alcor6502/USB-Relay-Altium/README.md

# Altium Project for a USB Controlled Relay

## Follow the project on [Hackaday](https://hackaday.io)

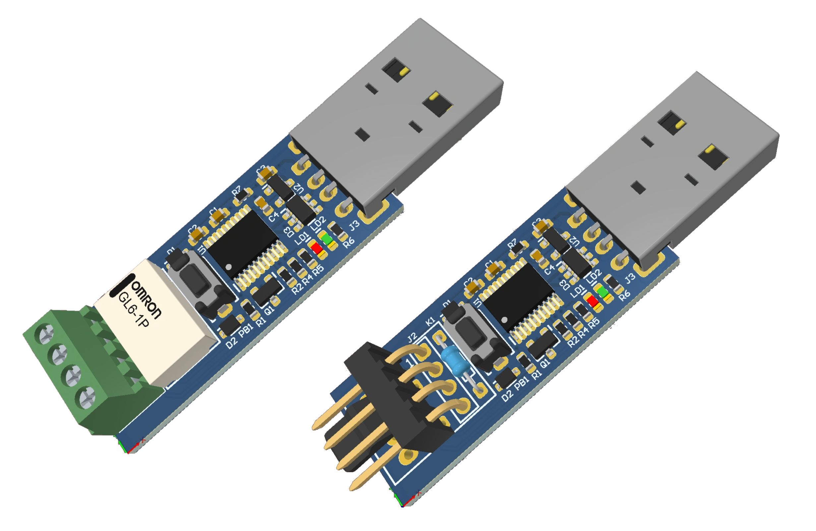
[picture p1: Documentation/Pictures/Board.png]
image info
