alcor6502/USB-Relay-Altium/Documentation/USB-SW-A/Design Rules Check.html

Altium

# Design Rule Verification Report

Date: | | 24/10/2024
Time: | | 17:12:43
Elapsed Time: | | 00:00:01
Filename: | | C:\Users\alfredo\AppData\Local\TempReleases\Snapshot\1\USB-SW.PcbDoc

Warnings: | | 0
Rule Violations: | | 0

## Summary

Warnings | Count
Total | 0

Rule Violations | Count
Clearance Constraint (Gap=0.2mm) (All),(All) | 0
Short-Circuit Constraint (Allowed=No) (All),(All) | 0
Un-Routed Net Constraint ( (All) ) | 0
Modified Polygon (Allow modified: No), (Allow shelved: No) | 0
Width Constraint (Min=0.1mm) (Max=5mm) (Preferred=0.2mm) (All) | 0
Routing Layers(All) | 0
Routing Via (MinHoleWidth=0.15mm) (MaxHoleWidth=1mm) (PreferredHoleWidth=0.3mm) (MinWidth=0.25mm) (MaxWidth=2mm) (PreferedWidth=0.5mm) (All) | 0
Differential Pairs Uncoupled Length using the Gap Constraints (Min=0.1mm) (Max=0.14mm) (Prefered=0.14mm) and Width Constraints (Min=0.3mm) (Max=0.4mm) (Prefered=0.4mm) (InDifferentialPair ('USB_D') Or InDifferentialPair ('USB_CON_D')) | 0
SMD To Corner (Distance=0.1mm) (All) | 0
SMD Entry (Side = Allowed) (Corner = Allowed) (Any Angle = Allowed) (Ignore First Corner = Allowed) | 0
Power Plane Connect Rule(Direct Connect )(Expansion=0.5mm) (Conductor Width=0.2mm) (Air Gap=0.2mm) (Entries=4) (All) | 0
Minimum Annular Ring (Minimum=0.1mm) (IsVia) | 0
Minimum Annular Ring (Minimum=0mm) (IsPad AND(PadIsPlated = 'False') AND IsPadHoleValid AND (PadXSize_AllLayers > 0) AND (PadYSize_AllLayers > 0)) | 0
Minimum Annular Ring (Minimum=0.2mm) (IsPad) | 0
Acute Angle Constraint [Tracks Only] (Minimum=60.000) (All) | 0
Hole Size Constraint (Min=0.5mm) (Max=10mm) (isPad AND PadIsPlated AND HasSlotHole AND IsPadHoleValid) | 0
Hole Size Constraint (Min=0.15mm) (Max=1mm) (IsVia) | 0
Hole Size Constraint (Min=0.15mm) (Max=100mm) (IsPad) | 0
Hole Size Constraint (Min=0.5mm) (Max=100mm) (isPad AND NOT PadIsPlated AND NOT HasSlotHole AND IsPadHoleValid) | 0
Hole Size Constraint (Min=1mm) (Max=10mm) (isPad AND NOT PadIsPlated AND HasSlotHole AND IsPadHoleValid) | 0
Pads and Vias to follow the Drill pairs settings | 0
Hole To Hole Clearance (Gap=0.2mm) (IsVia),(IsVia) | 0
Hole To Hole Clearance (Gap=0.45mm) (IsPad),(IsPad) | 0
Minimum Solder Mask Sliver (Gap=0.2mm) (All),(All) | 0
Silk To Solder Mask (Clearance=0.1mm) (All),(All) | 0
Silk to Silk (Clearance=0.1mm) (All),(All) | 0
Silk to Silk (Clearance=0.15mm) (IsPad),(All) | 0
Net Antennae (Tolerance=0mm) (All) | 0
Board Clearance Constraint (Gap=0mm) ((OnLayer('Top Layer') OR OnLayer('Bottom Layer'))) | 0
Parallel Segment Constraint (Gap=0.2mm ) (Limit=200mm) (All),(All) | 0
Matched Lengths(Delay Tolerance=50ps) (InDifferentialPair ('USB_D') Or InDifferentialPair ('USB_CON_D')) | 0
Daisy Chain Stub Length(Maximum =4mm) (All) | 0
Vias Under SMD Constraint (Allowed=Not Allowed) (All) | 0
Component Clearance Constraint ( Horizontal Gap = 0mm, Vertical Gap = 0mm ) (Footprint Like('FID-1*')),(All) | 0
Component Clearance Constraint ( Horizontal Gap = 0.2mm, Vertical Gap = 0.2mm ) (All),(All) | 0
Component Clearance Constraint ( Horizontal Gap = 0mm, Vertical Gap = 0mm ) ((InComponent('J2') OR InComponent('J3') OR InComponent('K1'))),((InComponent('J2') OR InComponent('J3') OR InComponent('K1'))) | 0
Height Constraint (Min=0mm) (Max=50mm) (Prefered=12mm) (All) | 0
Total | 0
