alcor6502/USB-Relay-Altium/Documentation/Data Sheets/MCU/TIM2 Block diagram.png

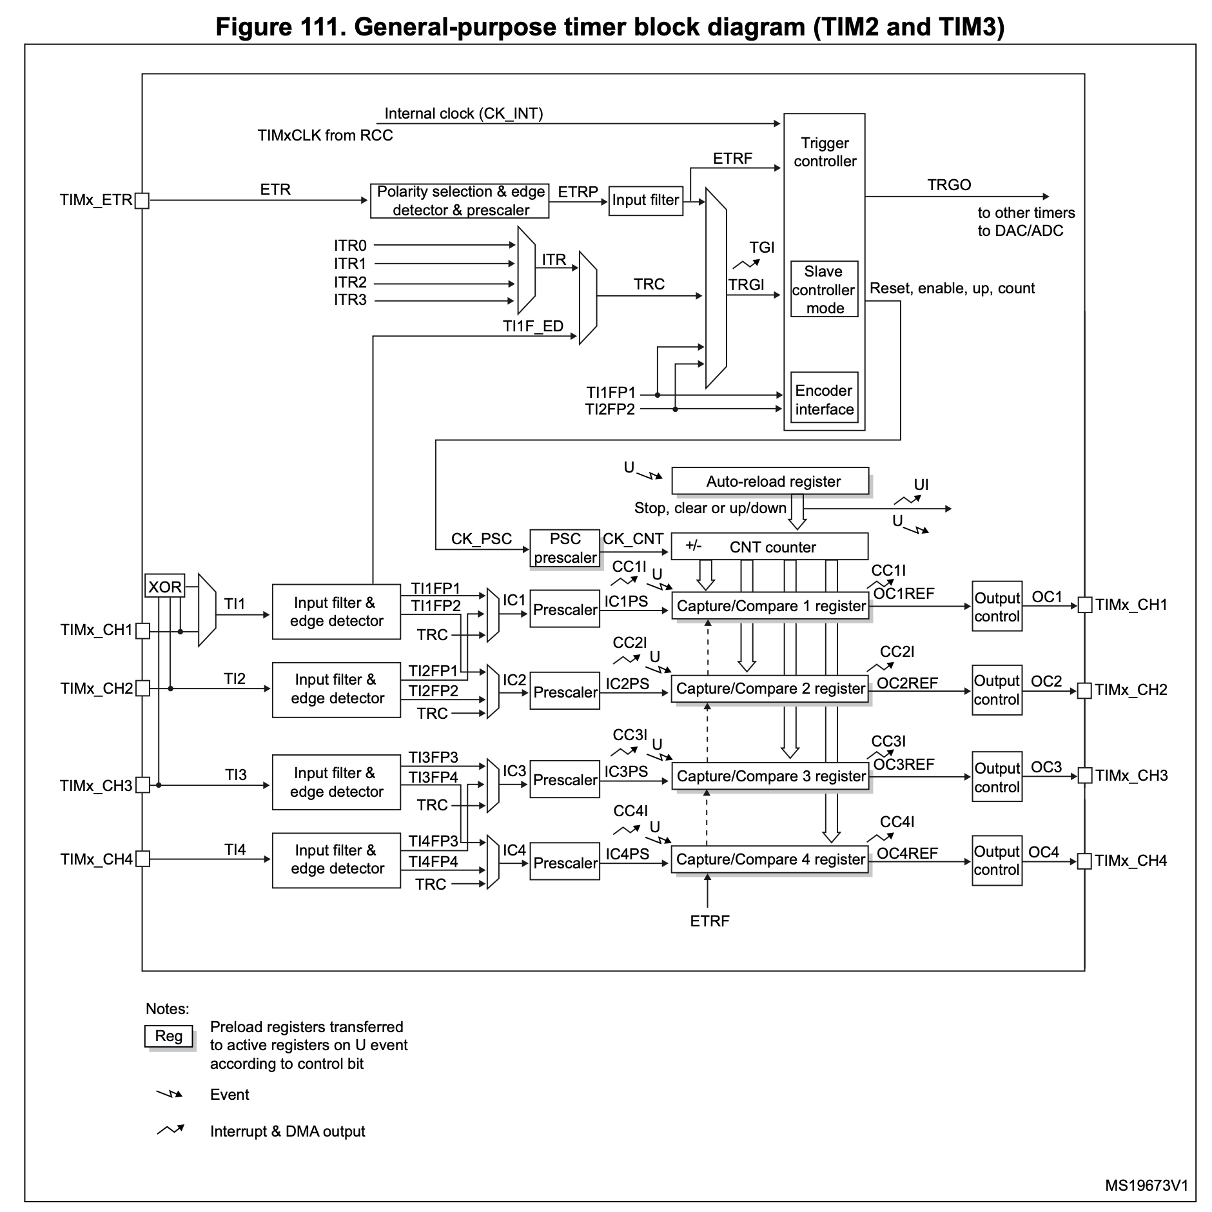
Documentation/Data Sheets/MCU/TIM2 Block diagram.png
