alcor6502/USB-Relay-Altium/Documentation/Pictures/Board Fan.png

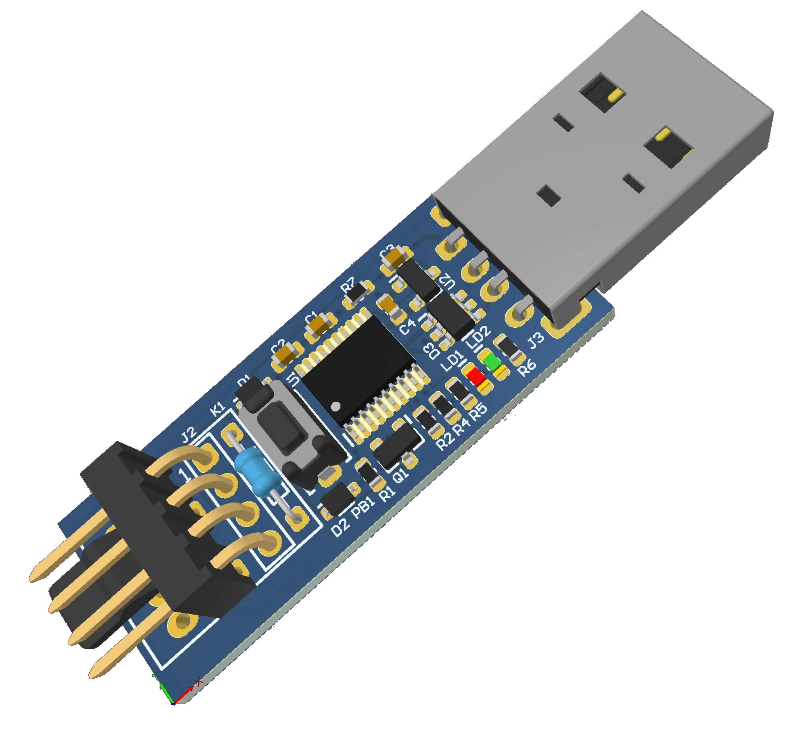
Documentation/Pictures/Board Fan.png
