alcor6502/USB-Relay-Altium/Documentation/USB-SW-B/BOM Complete.xls

Board: USB-SW-B |  |  |  |  |  |  |  | USB-SW-B
Project: USB Controlled Relay |  |  |  |  |  |  |  | USB Controlled Relay
Revision: B |  |  |  |  |  |  |  | B
Variant: None |  |  |  |  |  |  |  | None
 |  |  |  |  |  |  |  | 16/02/2025
Line # | Designator | Manufacturer | Manufacturer Part Number | Description | Case | Mount | Quantity | Supplier 1 | Supplier Part Number 1 | Supplier Order Qty 1 | Supplier Stock 1 | Supplier Unit Price 1 | Supplier Subtotal 1
1 | C1 | TDK | CGA3E2X7R1H104K080AA | Cap 0603 Case Ceramic 100nF 50V X7R | 0603 | Surface Mount | 1 | Mouser | 810-CGA3E2X7R1H104K | 10 | 1401871 | 0.04 | 0.38
2 | C2, C3, C4 | TDK | C1608X7R1C105K080AC | Cap 0603 Case Ceramic 1uF 16V X7R | 0603 | Surface Mount | 3 | Mouser | 810-C1608X7R1C105K | 30 | 255141 | 0.05 | 1.59
3 | D1, D2 | ON Semiconductor | MBR0530T1G | Diode Schottky 30V 0.5A 2-Pin SOD-123 | SOD-123 | Surface Mount | 2 | Mouser | 863-MBR0530T1G | 20 | 1564906 | 0.14 | 2.78
4 | D3 | STMicroelectronics | USBLC6-4SC6 | ESD Protection Diodes / TVS Diodes 2 Line 2.5pF USB 2.0 ESD Protect SOT23-6 | SOT-23-6 | Surface Mount | 1 | Mouser | 511-USBLC6-4SC6 | 10 | 47580 | 0.23 | 2.33
5 | J1 | Wurth Electronics | 691210910004 | Conn Term Block Header Screw 2.54 mm 4 Pos 6A 150V |  | Through Hole | 1 | Mouser | 710-691210910004 | 10 | 2027 | 1.77 | 17.70
6 | J2 | Moddy | CO975 | Conn Post Header - PWM Fan - 90 Deg - 4 Pos - Series KK254 |  | Through Hole | 1 | Moddy | CO975 | 10 | 1000 | 0.44 | 4.40
7 | J3 | Adam Tech | USB-AP-S-RA | Conn USB Type A Plug Right-Anglel TH |  | Through Hole | 1 | Mouser | 737-USB-AP-S-RA | 10 | 15588 | 0.34 | 3.35
8 | K1 | Omron | G6L-1P-DC5 | Relay Low Signal Sealed SPST-NO 1A 5VDC Through Hole Tube |  | Through Hole | 1 | Mouser | 653-G6L-1P-DC5 | 10 | 4124 | 2.37 | 23.70
9 | LD1 | Vishay Semiconductors | LTST-C191KRKT | LED 0603 Top Red 631nm 2-Pin | 0603 | Surface Mount | 1 | Mouser | 859-LTST-C191KRKT | 10 | 153119 | 0.12 | 1.17
10 | LD2 | Vishay Semiconductors | LTST-C191KGKT | LED 0603 Top Green 571nm 2-Pin | 0603 | Surface Mount | 1 | Mouser | 859-LTST-C191KGKT | 10 | 109093 | 0.12 | 1.25
11 | PB1 | Alps Alpine | SKQMAQE010 | Tactile Switch Rectangular 6.00x3.55mm. Height 4.3mm. J-Lead 50mA 12VDC 260gf SMD |  | Surface Mount | 1 | Mouser | 688-SKQMAQ | 10 | 2709 | 0.66 | 6.57
12 | Q1 | Diodes | BSS138-7-F | Mosfet N 50V Vds 20V Vgs 1.4R SOT-23 | SOT-23 | Surface Mount | 1 | Mouser | 621-BSS138-7-F | 10 | 145289 | 0.09 | 0.85
13 | R1, R4, R7 | Yageo | RC0603FR-0710KL | Resistor 0603 Case 10KR 1% 1/10W | 0603 | Surface Mount | 3 | Mouser | 603-RC0603FR-0710KL | 30 | 4994490 | 0.01 | 0.27
14 | R2, R5, R6 | Yageo | RC0603FR-07470RL | Resistor 0603 Case 470R 1% 1/10W | 0603 | Surface Mount | 3 | Mouser | 603-RC0603FR-07470RL | 30 | 728372 | 0.01 | 0.24
15 | R3 | SEI Stackpole | RNF18FTD10K0 | Resistor Axial 10KR 1% 1/8W | Through Hole | Through Hole | 1 | Mouser | 708-RNF18FTD10K0 | 10 | 102462 | 0.04 | 0.35
16 | U1 | STMicroelectronics | STM32F070F6P6 | STM32 Arm Cortex-M0 MCU 32 Kbytes of Flash 48 MHz CPU, USB | TSSOP-20 | Surface Mount | 1 | Mouser | 511-STM32F070F6P6TR | 10 | 1828 | 1.05 | 10.50
17 | U2 | Diodes | AP7313-33SRG-7 | LDO 3.3V 150mA Out 6Vin 130mV Dropout, Quiescent current 65uA Startup 80µs SOT-23 | SOT-23 | Surface Mount | 1 | Mouser | 621-AP7313-33SRG-7 | 10 | 54165 | 0.16 | 1.61
 | Total Parts | 17 |  |  |  |  | 10 | pcs: | Total | $79.04
 | Surface Mount Parts | 12
 | Through Hole Parts | 5 |  |  |  |  |  |  | Price for 1pcs | $7.90
 | Free Hanging Parts | 0
