alcor6502/USB-Relay-Altium/Documentation/USB-SW-A/BOM Complete.xls

Board: USB-SW-A |  |  |  |  |  |  |  | USB-SW-A
Project: USB controlled Relay |  |  |  |  |  |  |  | USB controlled Relay
Revision: A |  |  |  |  |  |  |  | A
Variant: None |  |  |  |  |  |  |  | None
 |  |  |  |  |  |  |  | 24/10/2024
Line # | Designator | Manufacturer | Manufacturer Part Number | Description | Case | Mount | Quantity | Supplier 1 | Supplier Part Number 1 | Supplier Order Qty 1 | Supplier Stock 1 | Supplier Unit Price 1 | Supplier Subtotal 1
 | C1 | TDK | CGA3E2X7R1H104K080AA | Cap 0603 Case Ceramic 100nF 50V X7R | 0603 | Surface Mount | 1 | Mouser | 810-CGA3E2X7R1H104K | 100 | 2671699 | 0.02 | 2.20
 | C2, C3, C4 | TDK | C1608X7R1C105K080AC | Cap 0603 Case Ceramic 1uF 16V X7R | 0603 | Surface Mount | 3 | Mouser | 810-C1608X7R1C105K | 300 | 400455 | 0.03 | 8.40
 | D1 | STMicroelectronics | USBLC6-4SC6 | ESD Protection Diodes / TVS Diodes 2 Line 2.5pF USB 2.0 ESD Protect SOT23-6 | STO23-6 | Surface Mount | 1 | Mouser | 511-USBLC6-4SC6 | 100 | 60620 | 0.20 | 19.70
 | D2, D3 | ON Semiconductor | MBR0530T1G | Diode Schottky 30V 0.5A 2-Pin SOD-123 | SOD-123 | Surface Mount | 2 | Mouser | 863-MBR0530T1G | 200 | 1680794 | 0.08 | 16.20
 | J1 | Molex | 48037-0001 | Conn USB type A plug 4 pin Horizontal TH |  | Through Hole | 1 | Mouser | 538-48037-0001 | 100 | 6836 | 0.82 | 82.50
 | J2 | JST | S4B-XH-A(LF)(SN) | Conn Shrouded, Series JST XH, 4 Pos Header,(2.50mm) Through Hole, Right Angle Tin |  | Through Hole | 1 | Mouser | 306-S4B-XH-ALFSN | 100 | 61319 | 0.23 | 23.00
 | J3 | Molex | 70553-0038 | Conn Shrouded, Series Molex 70058, 4 Pos Header, (2.54mm) Through Hole, Right Angle Tin |  | Through Hole | 1 | Mouser | 538-70553-0038 | 100 | 6334 | 0.59 | 58.70
 | K1 | Omron | G6L-1P-DC5 | Relay Low Signal Sealed SPST-NO 1A 5VDC Through Hole Tube |  | Through Hole | 1 | Mouser | 653-G6L-1P-DC5 | 100 | 5264 | 1.90 | 190.00
 | LD1 | Vishay Lite-On | LTST-C191KRKT | LED 0603 Top Red 631nm 2-Pin | 0603 | Surface Mount | 1 | Mouser | 859-LTST-C191KRKT | 100 | 169916 | 0.05 | 5.30
 | LD2 | Vishay Lite-On | LTST-C191KGKT | LED 0603 Top Green 571nm 2-Pin | 0603 | Surface Mount | 1 | Mouser | 859-LTST-C191KGKT | 100 | 435065 | 0.05 | 5.20
 | PB1 | E-Switch | TL3302AF180QJ | Tactile Switch Rectangular 6.00x3.55mm. Height 4.3mm. J-Lead 50mA 12VDC 180gf SMD |  | Through Hole | 1
 | Q1 | Diodes | BSS138K-13 | Mosfet N 50V Vds 20V Vgs ESD 1.4R SOT-23 | SOT-23 | Surface Mount | 1 | Mouser | 621-BSS138K-13 | 100 | 334784 | 0.06 | 5.90
 | R1, R2, R6, R7 | Yageo | RC0603FR-0710KL | Resistor 0603 Case 10KR 1% 1/10W | 0603 | Surface Mount | 4 | Mouser | 603-RC0603FR-0710KL | 400 | 261371 | 0.01 | 2.80
 | R3, R4, R5 | Yageo | RC0603FR-07470RL | Resistor 0603 Case 470R 1% 1/10W | 0603 | Surface Mount | 3 | Mouser | 603-RC0603FR-07470RL | 300 | 1208113 | 0.01 | 1.80
 | U1 | STMicroelectronics | STM32F042F4P6 | STM32 Arm Cortex-M0 USB line MCU 16 Kbytes of Flash 48 MHz CPU USB CAN CEC | TSSOP-20 | Surface Mount | 1 | Mouser | 511-STM32F042F4P6 | 100 | 13406 | 1.66 | 166.00
 | U2 | Diodes | AP7313-33SRG-7 | LDO 3.3V 150mA Out 6Vin 130mV Dropout, Quiescent current 65uA Startup 80µs SOT-23 | SOT-223 | Surface Mount | 1 | Mouser | 621-AP7313-33SRG-7 | 100 | 55450 | 0.13 | 13.20
 | Total Parts | 16 |  |  |  |  | 100 | pcs: | Total | $600.90
 | Surface Mount Parts | 11
 | Through Hole Parts | 5 |  |  |  |  |  |  | Price for 1pcs | $6.01
 | Free Hanging Parts | 0
