alcor6502/USB-Relay-Altium/Documentation/Data Sheets/Relays/G6L-1P.step

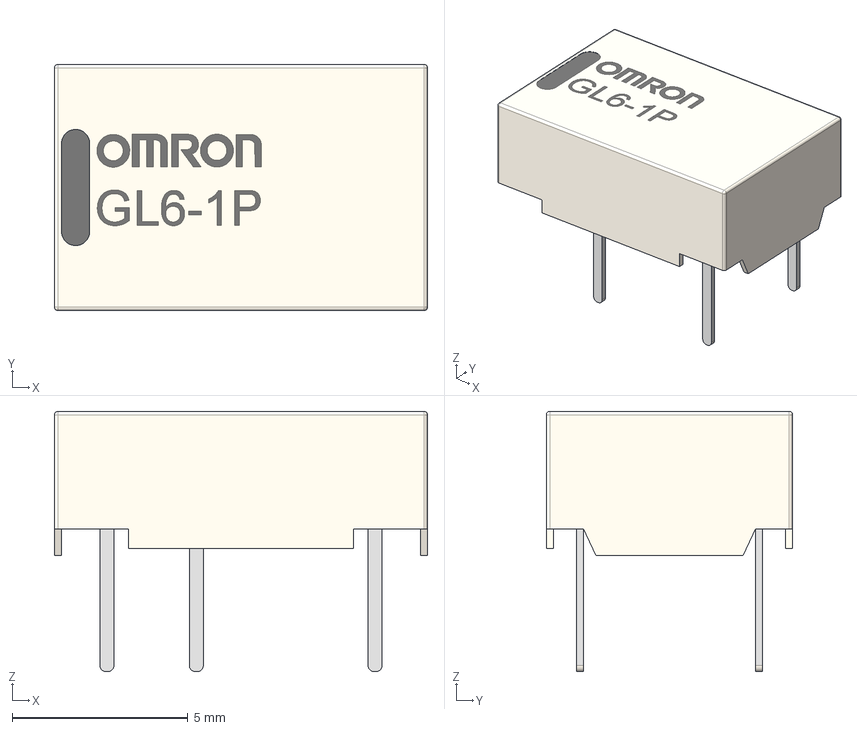
[picture p4: CAD file, 2024-09-18]
Documentation/Data Sheets/Relays/G6L-1P.step
10.6 x 7.00 x 7.40 mm
