alcor6502/USB-Relay-Altium/Documentation/USB-SW-A/Board 3D.step

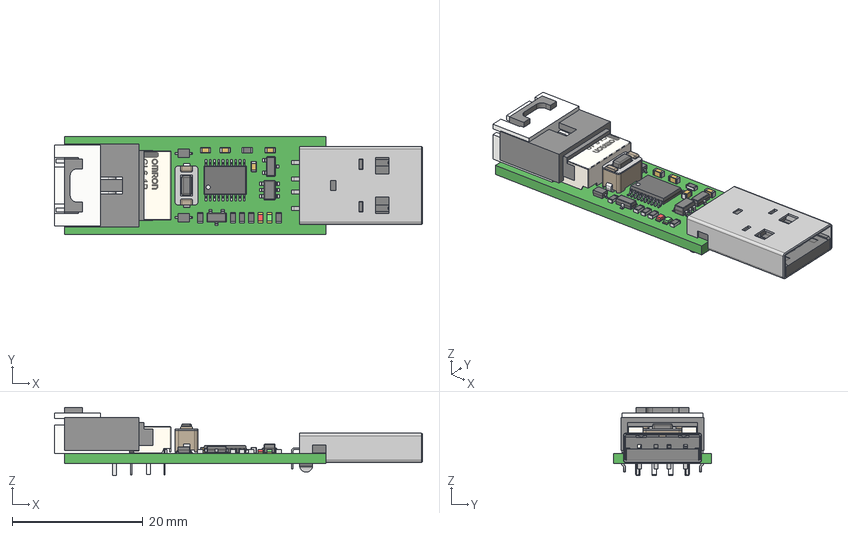
[picture p5: CAD file, 2024-10-24]
Documentation/USB-SW-A/Board 3D.step
56.3 x 15.0 x 10.4 mm
Mid_Body x 7
Mark x 7
SOD-323-J x 2
TL3302AF180QJ
Leader x 12
_X2_041A043E0440043F04430441_X0_
_X2_041C04350442043A0430_X0_
_X2_041D043E0436043A0430_X0_ x 10
Extruded x 4
G6L-1P
S4B-XH-A
