alcor6502/USB-Relay-Altium/Documentation/USB-SW-B/Board 3D.step

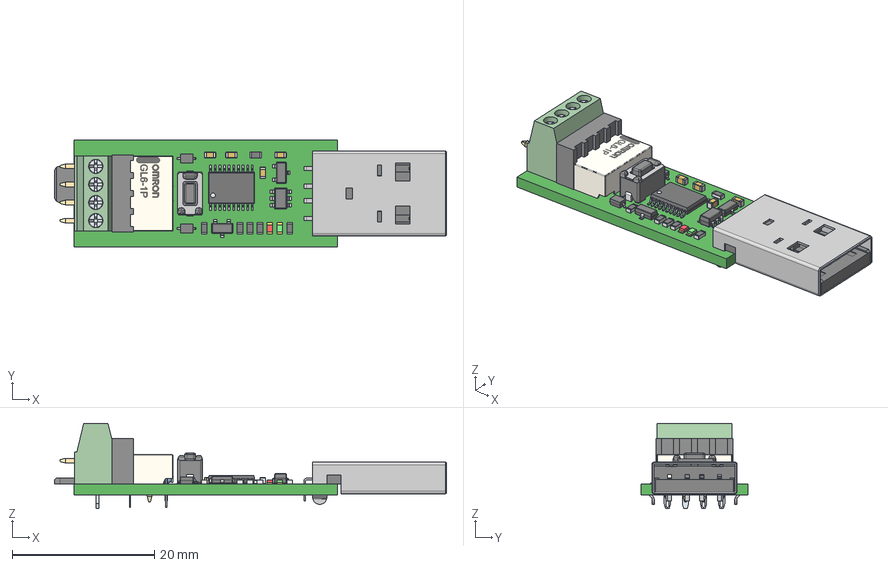
[picture p6: CAD file, 2025-02-16]
Documentation/USB-SW-B/Board 3D.step
55.0 x 15.0 x 12.0 mm
Leader x 12
Fan Header 90deg
Mid_Body x 6
Mark x 6
Resitor Through Hole 125 mW
SOD-323-J x 2
SKQMBA
_X2_041A043E0440043F04430441_X0_
_X2_041C04350442043A0430_X0_
_X2_041D043E0436043A0430_X0_ x 10
Extruded x 4
G6L-1P
6912109100xx_CAGE x 4
6912109100xx_PIN x 4
6912109100xx_VIS x 4
