alcor6502/USB-Relay-Altium/Documentation/Data Sheets/Relays/G5V-1.step

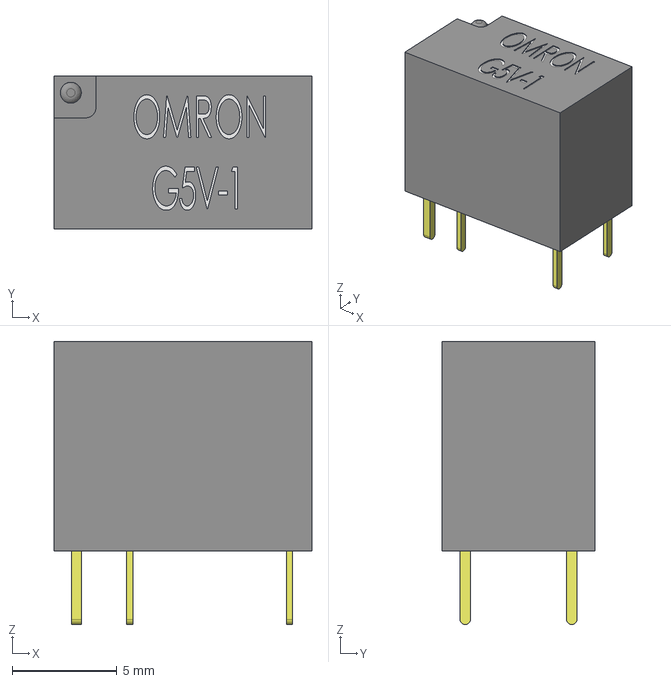
[picture p7: CAD file, 2024-09-18]
Documentation/Data Sheets/Relays/G5V-1.step
12.3 x 7.30 x 13.5 mm
