alcor6502/USB-Relay-Altium/Documentation/USB-SW-A/Schematics.PDF

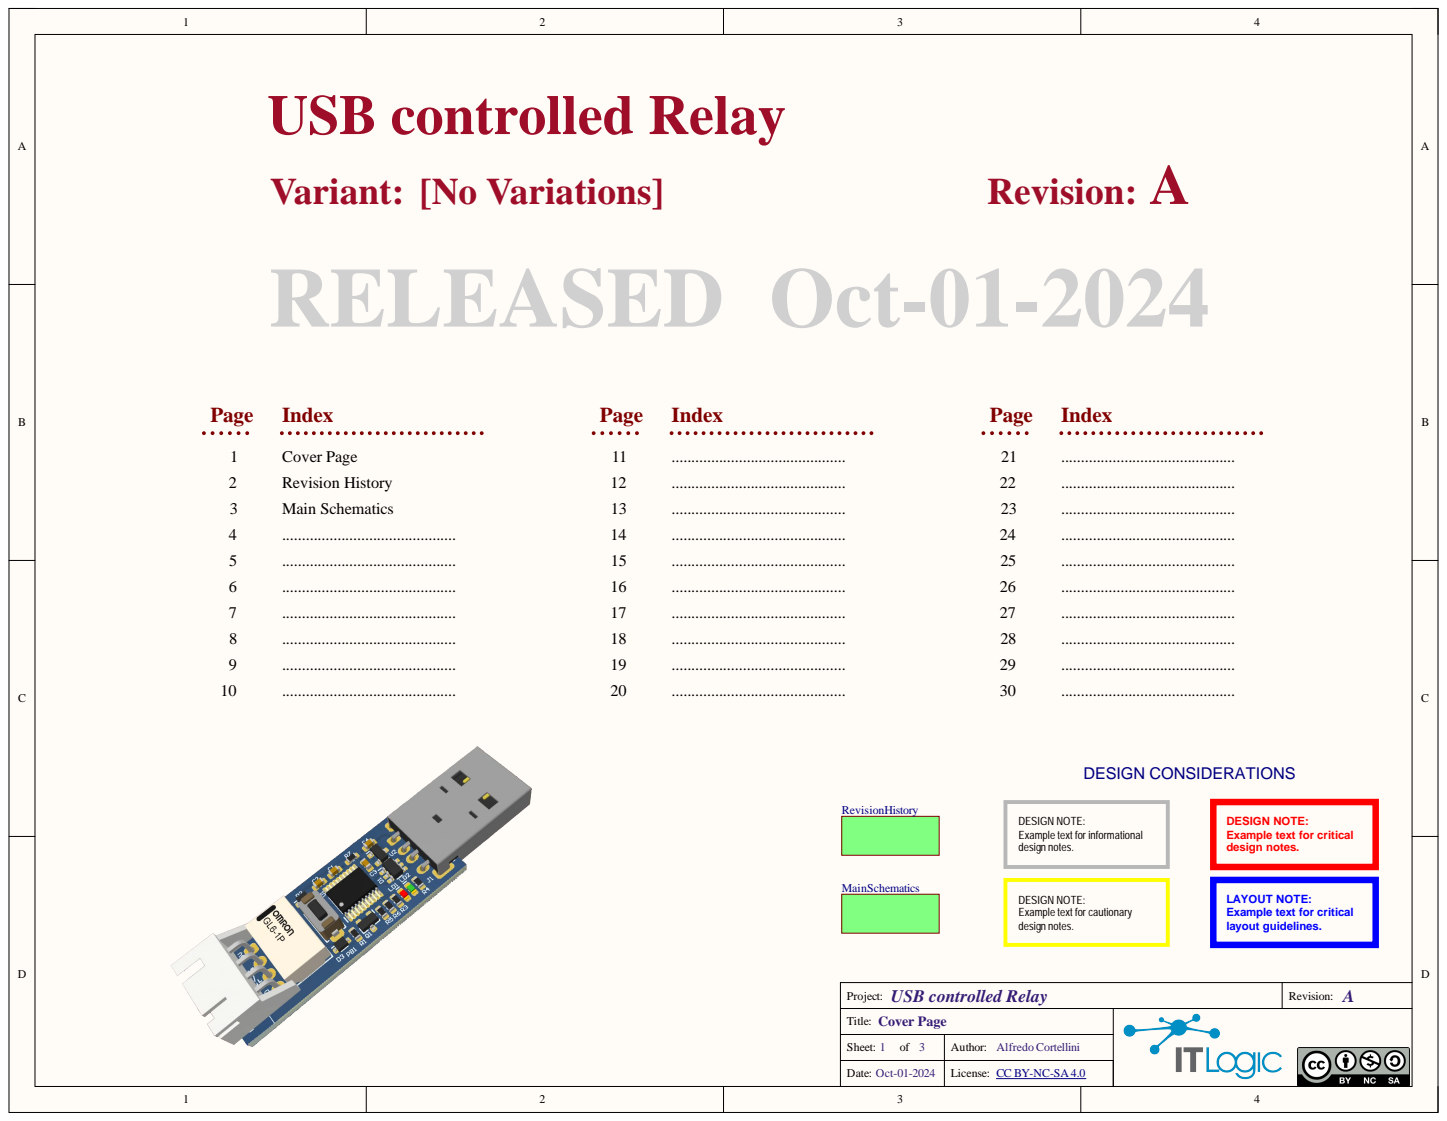
[picture p11: page 1]

DESIGN NOTE:
Example text for informational
design notes.

Example text for critical

Example text for cautionary

LAYOUT NOTE:
layout guidelines.

Project: USB controlled Relay

License: CC BY-NC-SA4.0

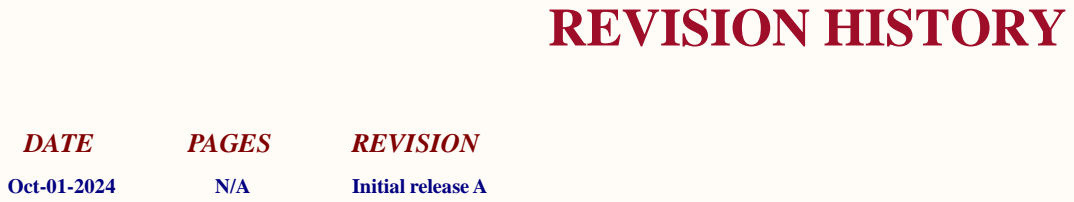
[picture p12: page 2]

Project: USB controlled Relay

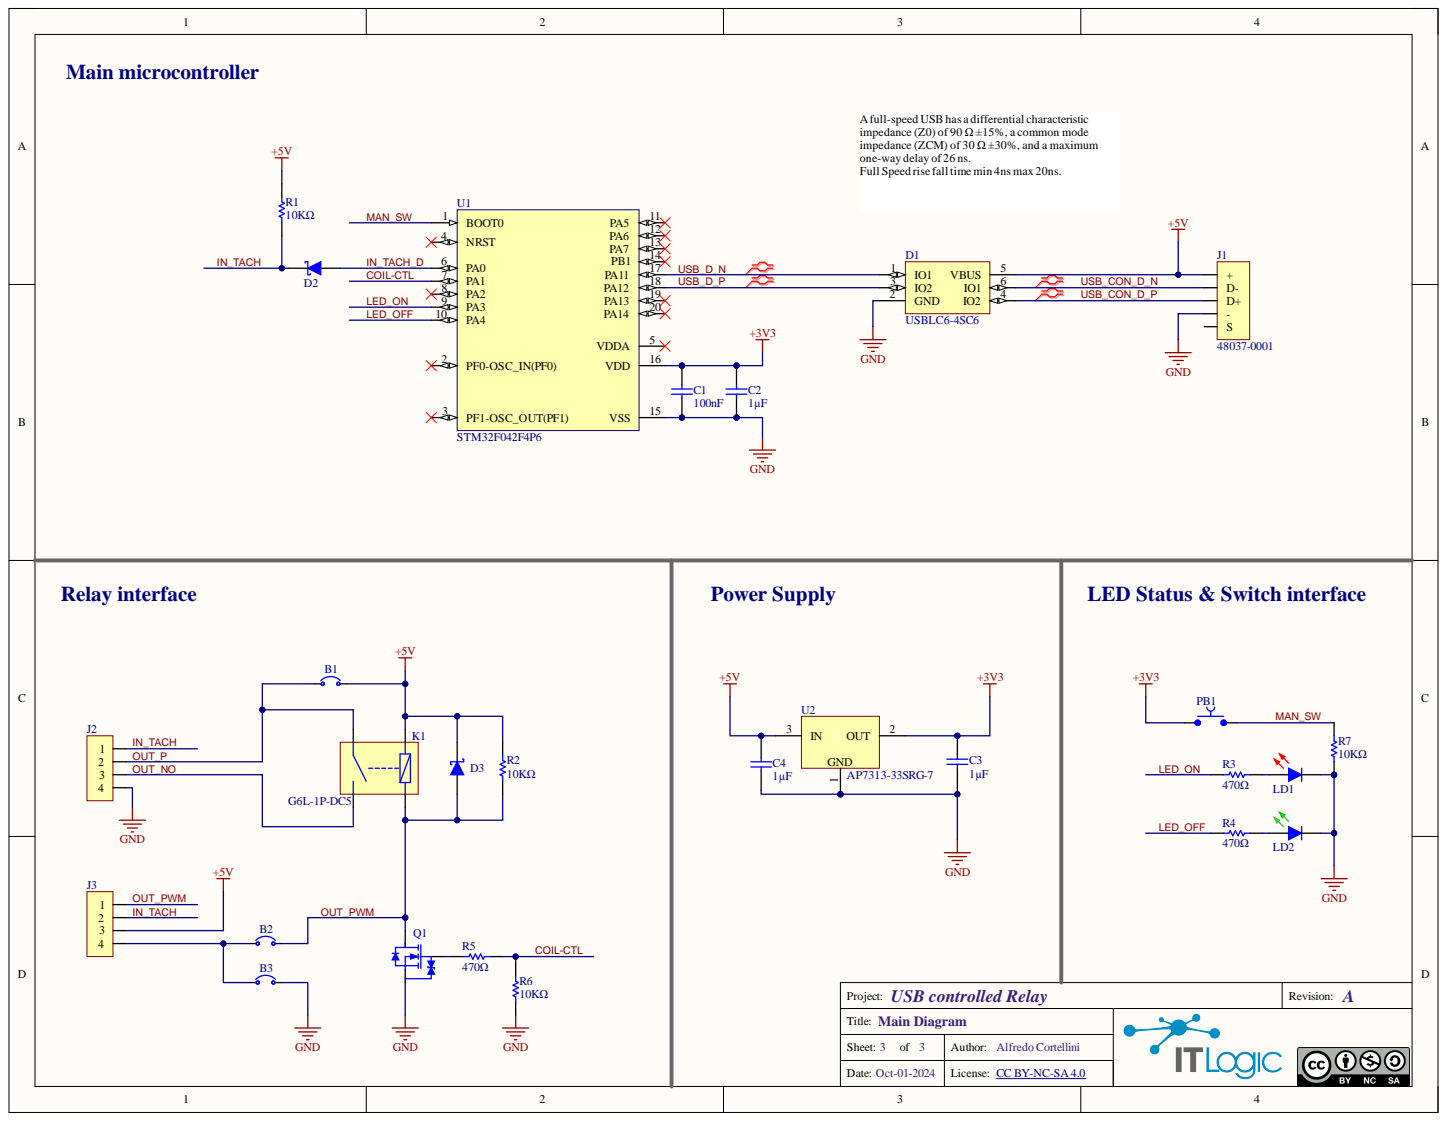
[picture p13: page 3]

Afull-speed USB has a differential characteristic
impedance (Z0) of 90 Ω ±15%, a common mode
impedance (ZCM) of 30 Ω ±30%, and a maximum
one-way delay of 26 ns.
Full Speed rise fall time min 4ns max 20ns.

Project: USB controlled Relay
