alcor6502/USB-Relay-Altium/Documentation/USB-SW-A/Drawings.pdf

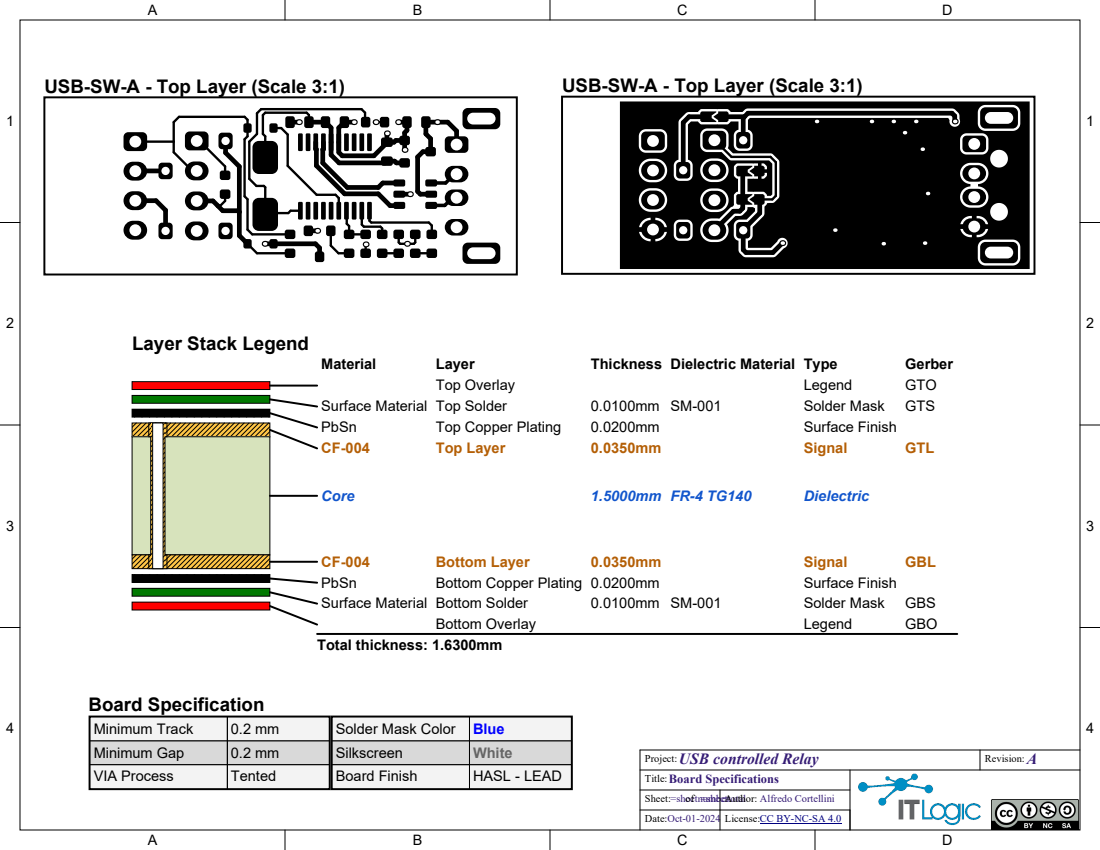
[picture p18: page 1]

Minimum Track | 0.2 mm | Solder Mask Color | Blue
Minimum Gap | 0.2 mm | Silkscreen | White
VIA Process | Tented | Board Finish | HASL - LEAD

Project:USB controlled Relay
Board Specifications
Title:

Sheet: =sheetnumber =sheettotal of | Author: Alfredo Cortellini

License:CC BY-NC-SA 4.0

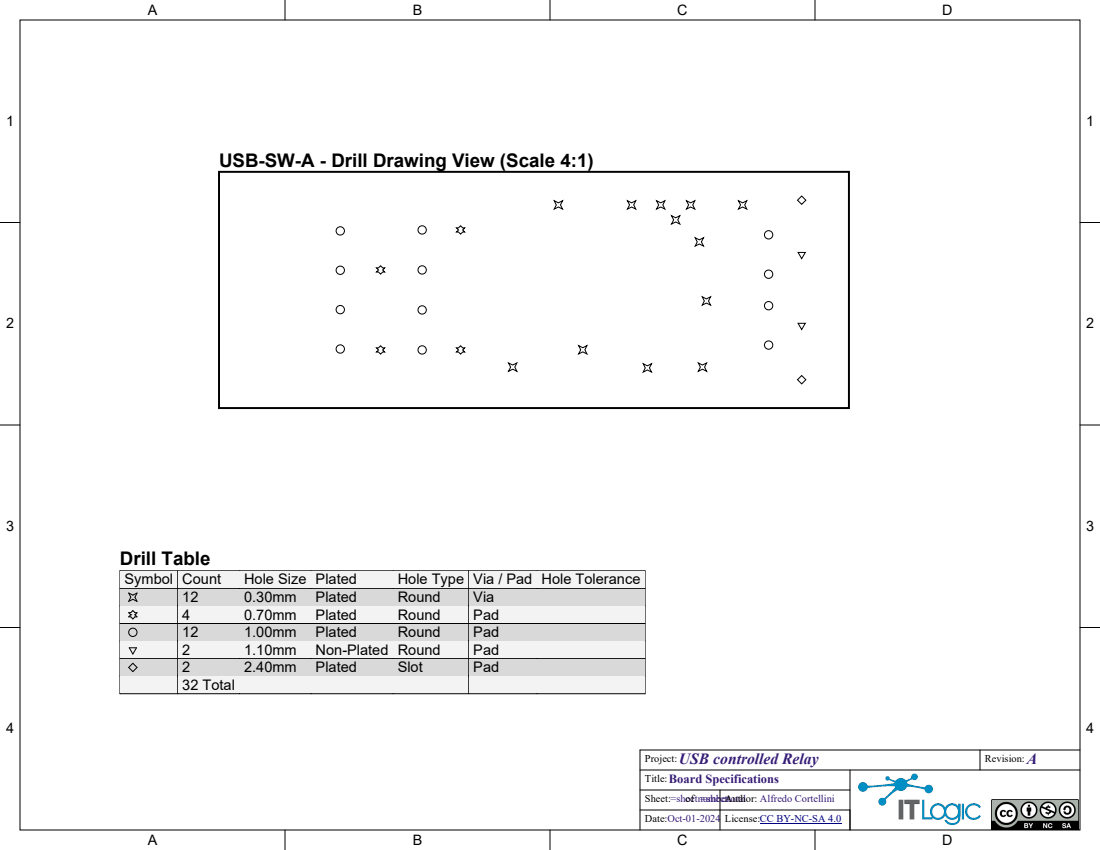
[picture p19: page 2]

USB-SW-A - Drill Drawing View (Scale 4:1)

Symbol | Count | Hole Size | Plated | Hole Type | Via / Pad | Hole Tolerance

12 | 0.30mm | Plated | Round | Via
4 | 0.70mm | Plated | Round | Pad
12 | 1.00mm | Plated | Round | Pad
2 | 1.10mm | Non-Plated | Round | Pad
2 | 2.40mm | Plated | Slot | Pad
32 Total

Project:USB controlled Relay
Board Specifications
Title:

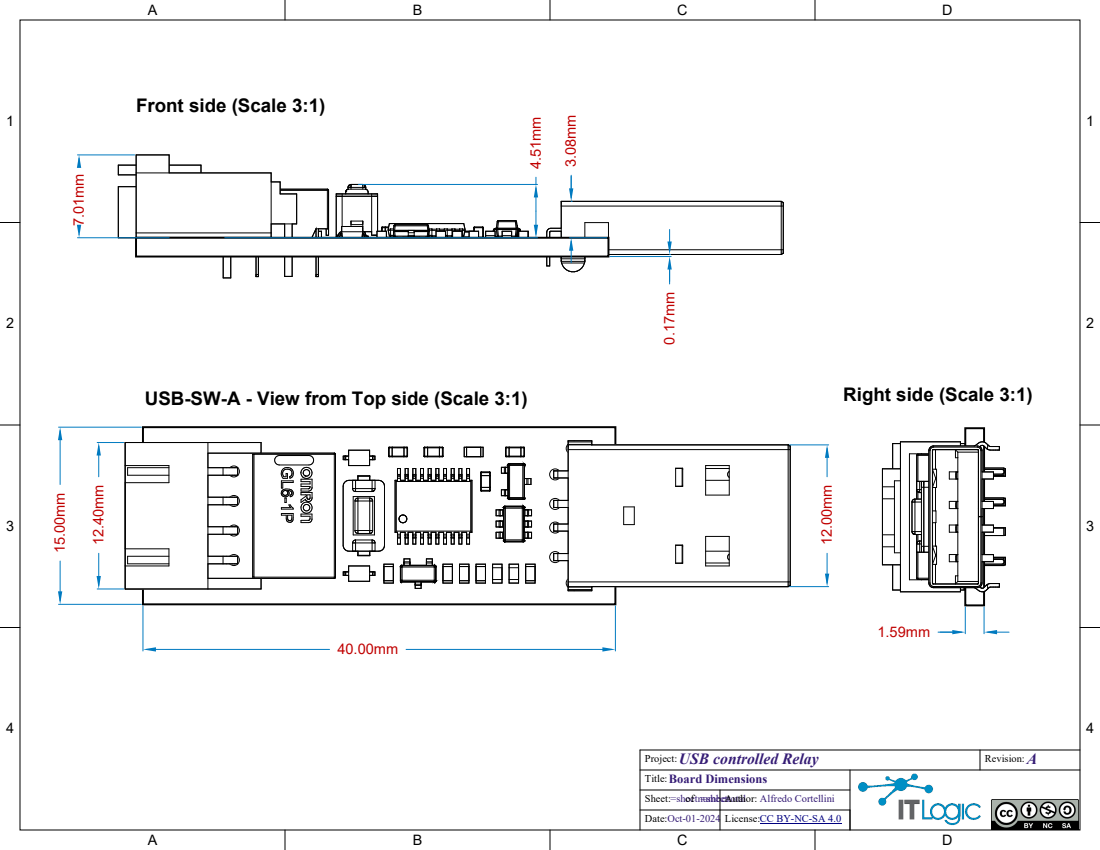
[picture p20: page 3]

USB-SW-A - View from Top side (Scale 3:1)

Project:USB controlled Relay
Board Dimensions
Title:

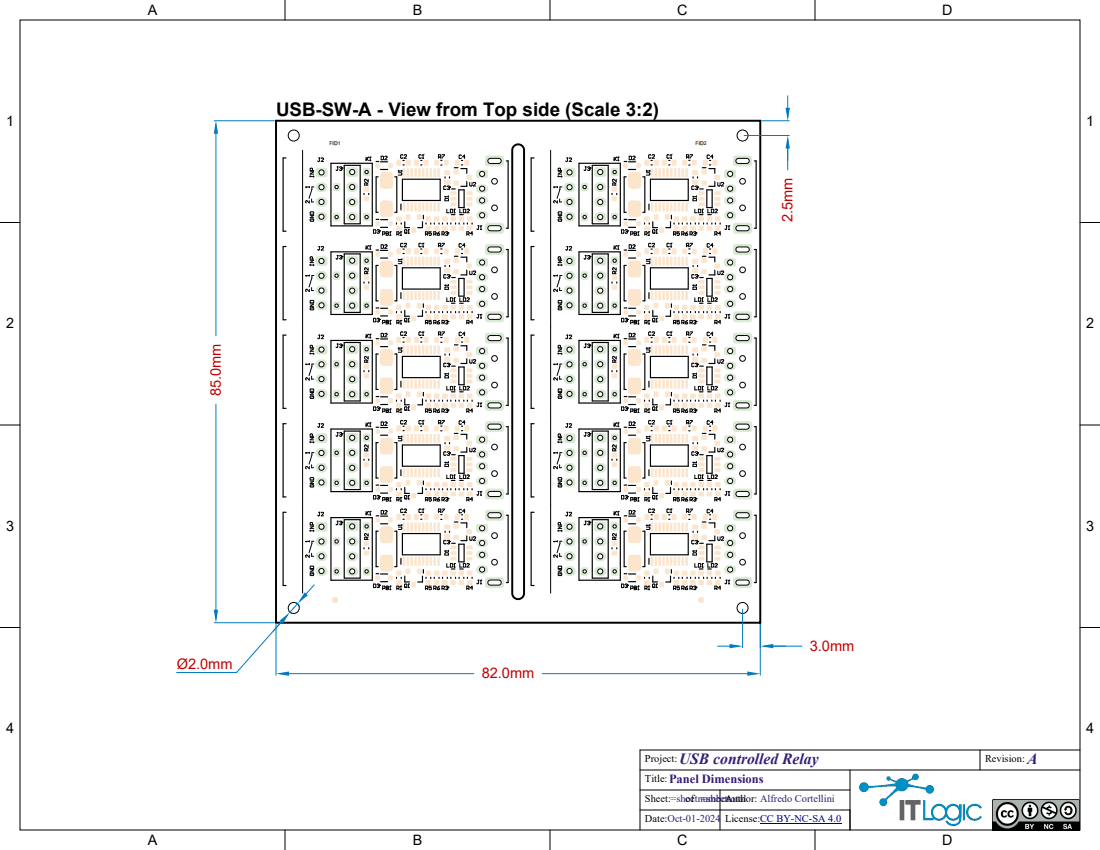
[picture p21: page 4]

USB-SW-A - View from Top side (Scale 3:2)

Project:USB controlled Relay
Panel Dimensions
Title:

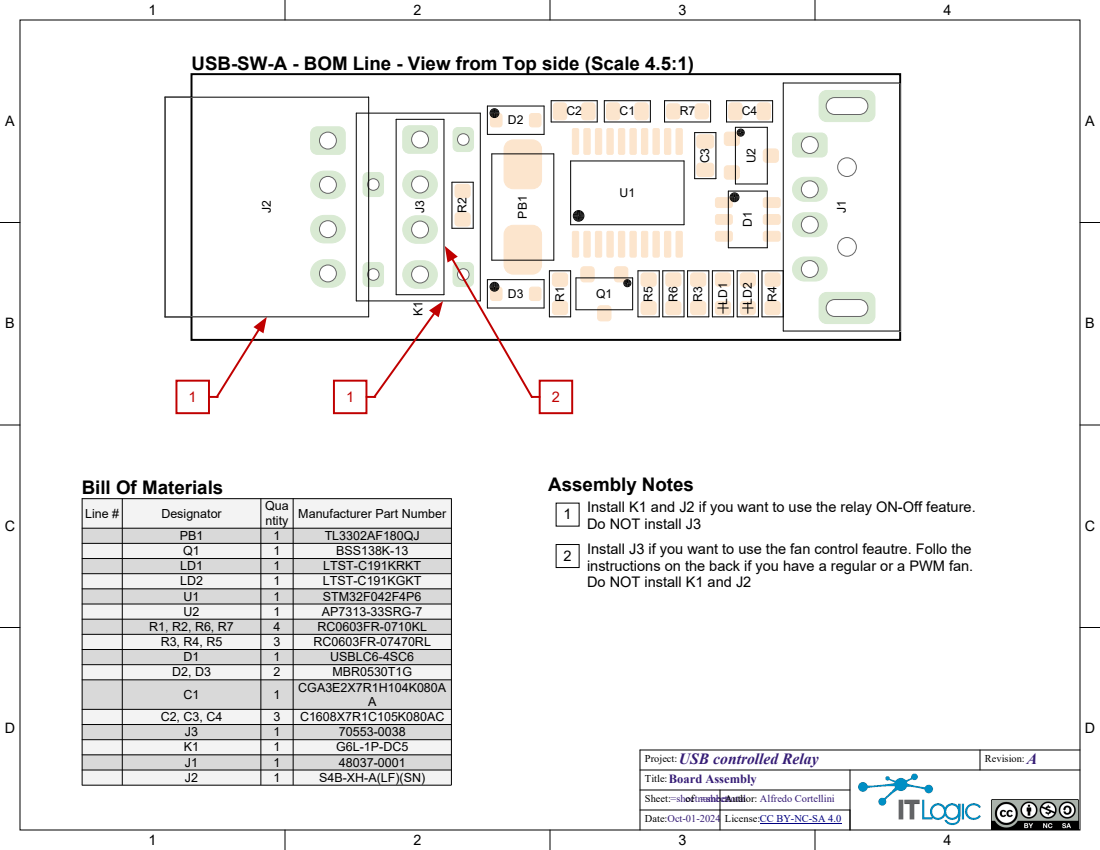
[picture p22: page 5]

USB-SW-A - BOM Line - View from Top side (Scale 4.5:1)

Assembly Notes
Install K1 and J2 if you want to use the relay ON-Off feature.
Do NOT install J3
Install J3 if you want to use the fan control feautre. Follo the
instructions on the back if you have a regular or a PWM fan.
Do NOT install K1 and J2

Line # | Designator | Qua ntity | Manufacturer Part Number

LD1 | 1 | LTST-C191KRKT
LD2 | 1 | LTST-C191KGKT
U1 | 1 | STM32F042F4P6
U2 | 1 | AP7313-33SRG-7
R1, R2, R6, R7 | 4 | RC0603FR-0710KL
R3, R4, R5 | 3 | RC0603FR-07470RL
D1 | 1 | USBLC6-4SC6
D2, D3 | 2 | MBR0530T1G
C1 | 1 | CGA3E2X7R1H104K080A A

C2, C3, C4 | 3 | C1608X7R1C105K080AC
J3 | 1 | 70553-0038
K1 | 1 | G6L-1P-DC5
J1 | 1 | 48037-0001
J2 | 1 | S4B-XH-A(LF)(SN)

Project:USB controlled Relay
Board Assembly
Title:
