alcor6502/USB-Relay-Altium/(list of files, drawings)

Other design files:
Board.PcbDoc
Cover Page.SchDoc
Main Schematics.SchDoc
Panel.PcbDoc
Revision History.SchDoc
Usb Relay.PrjPcb
