alcor6502/USB-Relay-Altium/(commit log)

2024-09-18 Deploy from project template
    [Block Diagram.SchDoc, Cover Page.SchDoc, G5V-1.step, G6L-1P.step, PANEL.PcbDoc, Revision History.SchDoc, USB-SW.PcbDoc, Usb Relay.PrjPcb]
2024-09-18 Updated parameters for the new project
    [Usb Relay.PrjPcb]
2024-09-23 Schematic Completed
    [Cover Page.SchDoc, Main Diagram.SchDoc, Revision History.SchDoc]
2024-09-25 Design Finished
    [Cover Page.SchDoc, Main Schematics.SchDoc, Revision History.SchDoc, USB-SW.PcbDoc, Usb Relay.PrjPcb]
2024-10-13 Redy for Panel design
    [Main Schematics.SchDoc, USB-SW.PcbDoc, Usb Relay.PrjPcb]
2024-10-14 Minor bugs
    [Main Schematics.SchDoc, USB-SW.PcbDoc]
2024-10-17 First launch project releaser
    [Cover Page.SchDoc, Main Schematics.SchDoc, PANEL.PcbDoc, USB-SW.PcbDoc, Usb Relay.PrjPcb]
2024-10-17 Fixed some minor errors
    [PANEL.PcbDoc, USB-SW.PcbDoc]
2024-10-17 Fixed path for releaser
    [Usb Relay.PrjPcb]
2024-10-23 Added product code
    [USB-SW.PcbDoc]
2024-10-23 Regen Gerbers
    [BOM Basic.xlsx, BOM Complete.xls, Board 3D.step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]
2024-10-23 Moved text to avoid via hole
    [USB-SW.PcbDoc]
2024-10-23 Changed +5v pin to an input
    [Main Schematics.SchDoc, USB-SW.PcbDoc]
2024-10-24 Removed local Fiducials, Adjusted copper poor clearence with the board
    [Main Schematics.SchDoc, USB-SW.PcbDoc]
2024-10-24 Fixed mechanical layer
    [USB-SW.PcbDoc]
2024-10-24 Revision A
    Revision submitted to JLC-PCB
    [BOM Basic.xlsx, BOM Complete.xls, Board 3D.step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]
2025-02-13 Applied mods for release B
    [Cover Page.SchDoc, Main Schematics.SchDoc, PANEL.PcbDoc, Revision History.SchDoc, USB-SW.PcbDoc, Usb Relay.PrjPcb]
2025-02-13 Updated 3D board picture
2025-02-13 Per release B
    [USB-SW.PcbDoc, Usb Relay.PrjPcb]
2025-02-14 Pre Release B and some adjustments in Output Format
    [USB-SW.PcbDoc]
2025-02-14 Fixed new tempalte for drawings and schematics
    [Cover Page.SchDoc, Main Schematics.SchDoc, Revision History.SchDoc, USB-SW.PcbDoc, Usb Relay.PrjPcb]
2025-02-14 Fixed some typos in the schematics template
    [Cover Page.SchDoc, Main Schematics.SchDoc, Revision History.SchDoc]
2025-02-14 Fixed Page numbering in Schematics
    [Cover Page.SchDoc, Main Schematics.SchDoc, Revision History.SchDoc, Usb Relay.PrjPcb]
2025-02-14 Test Pick and Place for component rotation
    [BOM Complete.xls, Board 3D.step, Pick and Place.csv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]
2025-02-14 Changed name of the pcbdoc in a generic Board name
    [Board.PcbDoc, Panel.PcbDoc, Usb Relay.PrjPcb]
2025-02-14 Fixed board name in drawings
    [Usb Relay.PrjPcb]
2025-02-15 Changed paper size to A4
    [Cover Page.SchDoc, Main Schematics.SchDoc, Revision History.SchDoc, Usb Relay.PrjPcb]
2025-02-15 Changed PB1 and J3 with cheaper options
    [Cover Page.SchDoc, Main Schematics.SchDoc, Revision History.SchDoc, Usb Relay.PrjPcb]
2025-02-15 Test fabrication
    [BOM Basic.xlsx, BOM Complete.xls, Board 3D.step, Pick and Place.csv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]
2025-02-15 Changed capacitor and resistor value symbol
    [Board.PcbDoc, Main Schematics.SchDoc, Revision History.SchDoc, Usb Relay.PrjPcb]
2025-02-15 Test release B
    [BOM Basic.xlsx, BOM Complete.xls, Board 3D.step, JLCPCB BOM.csv, Pick and Place.csv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]
2025-02-15 Submitted to JlcPCB for Release B
    [Board.PcbDoc, Main Schematics.SchDoc]
2025-02-15 Upload to JLCPCB - Rel B
    [BOM Basic.xlsx, BOM Complete.xls, Board 3D.step, JLCPCB BOM.csv, Pick and Place.csv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]
2025-02-16 Changed JST connctor with screw terminal block
    [Board.PcbDoc, Cover Page.SchDoc, Main Schematics.SchDoc, Panel.PcbDoc, Revision History.SchDoc]
2025-02-16 Upload JLCPCB for Release B
    [Panel.PcbDoc]
2025-02-16 Sync generated files
    [BOM Basic.xlsx, BOM Complete.xls, Board 3D.step, Pick and Place.csv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]
2025-02-16 Release B
    [Board.PcbDoc, Main Schematics.SchDoc, Revision History.SchDoc]
